DONGKHOA/MEASURE-POWER-AC/Firmware/ESP32/Measure_Power_AC/tbcmh/esp-mqtt_api.ods

Sheet: ESP-MQTT_API_&_Task_model
ESP-MQTT API | User context (User task) | MQTT event handler (Internal MQTT task) | Memo
esp_mqtt_client_init() | √
esp_mqtt_client_set_uri() | √ | *
esp_mqtt_client_start() | √
esp_mqtt_client_reconnect() | √
esp_mqtt_client_disconnect() | √
esp_mqtt_client_stop() | √ | X
esp_mqtt_client_subscribe() | √ | √ | Client must be connected to send subscribe message
esp_mqtt_client_unsubscribe() | √ | √ | Client must be connected to send unsubscribe message
esp_mqtt_client_publish() | √ | √ | This API might block for several seconds, either due to network timeout (10s) or if publishing payloads longer than internal buffer (due to message fragmentation)
esp_mqtt_client_enqueue() | √ | √ | This API generates and stores the publish message into the internal outbox and the actual sending to the network is performed in the mqtt-task context. Thus, it could be used as a non blocking version of esp_mqtt_client_publish().
esp_mqtt_client_destroy() | √ | X
esp_mqtt_set_config() | √ | *
esp_mqtt_client_register_event() | √
esp_mqtt_client_get_outbox_size() | √ | *
 |  |  | √:MUST, *:SHOULD, X:MUST NOT

Sheet: APIs_vs_function
Features API |  | MQTT | HTTP | CoAP
Telemetry upload API |  | PUBLISH, c->s | POST (REQ) | POST (REQ)
Attributes API | Publish attribute update to the server | PUBLISH, c->s | POST (REQ) | POST (REQ)
 | Request attribute values from the server | SUBSCRIBE, c->s PUBLISH(REQ), c->s PUBLISH(RES), c<-s | GET (REQ/request + RES/reply) | GET (REQ/request + RES/reply)
 | Subscribe to attribute updates from the server | SUBSCRIBE, c->s PUBLISH, c<-s | GET+timeout (RES/attr/timeout?) | GET+observe (RES/attr/?)
RPC API | Server-side RPC | SUBSCRIBE, c->s PUBLISH(REQ), c<-s PUBLISH(RES), c->s | GET+timeout (RES/request/timeout) POST (REQ/reply) | GET+observe (RES/attr/?) POST (REQ/reply)
 | Client-side RPC | SUBSCRIBE, c->s PUBLISH(REQ), c->s PUBLISH(RES), c<-s | POST (REQ/request + RES/reply) | POST (REQ/request + RES/reply)
Claiming devices |  | PUBLISH | POST (REQ) | POST (REQ)
Device provisioning |  | SUBSCRIBE, c->s PUBLISH(REQ), c->s PUBLISH(RES), c<-s | POST (REQ/request + RES/reply) | POST (REQ/request + RES/reply)
Firmware API | Request attribute values from the server(fw/sw) | SUBSCRIBE, c->s PUBLISH(REQ), c->s PUBLISH(RES), c<-s | GET (REQ/request + RES/reply) | GET (REQ/request + RES/reply)
 | Subscribe to attribute updates from the server (fw/sw) | SUBSCRIBE, c->s PUBLISH, c<-s | ??? | ???
 | New firmware update (fw/sw) | SUBSCRIBE, c->s PUBLISH(REQ), c->s PUBLISH(RES), c<-s | GET (REQ/request + RES/reply) | ???

Sheet: authentication_options
Device authentication options |  | MQTT (SSL/TLS) | HTTP (SSL/TLS) | CoAP (DTLS)
Access Token | without SSL | Plain MQTT | HTTP | CoAP
 | one-way SSL | MQTT over SSL | HTTPS | CoAP over DTLS
Basic MQTT authentication | without SSL | Plain MQTT | / | /
 | one-way SSL | MQTT over SSL | / | /
X.509 Certificate Based Authentication | two-way SSL | MQTT with X.509 | /? | CoAP with X.509 ?

Sheet: provision_options
Provision options | MQTT (SSL/TLS) | HTTP (SSL/TLS) | CoAP (DTLS)
Credentials generated by the ThingsBoard server | v | v | v
Devices supplies Access Token | v | v | v
Devices supplies Basic MQTT Credentials | v
Devices supplies X.509 Certificate | v |  | ?

Sheet: provision_params
Provisioning request | Parameter | Description | Credentials generated by the ThingsBoard server | Devices supplies Access Token | Devices supplies Basic MQTT Credentials | Devices supplies X.509 Certificate | esp_mqtt_client_config_t
 | deviceName | Device name in ThingsBoard. | (O) DEVICE_NAME | (O) DEVICE_NAME | (O) DEVICE_NAME | (O) DEVICE_NAME
 | provisionDeviceKey | Provisioning device key, you should take it from configured device profile. | (M) PUT_PROVISION_KEY_HERE | (M) PUT_PROVISION_KEY_HERE | (M) PUT_PROVISION_KEY_HERE | (M) PUT_PROVISION_KEY_HERE
 | provisionDeviceSecret | Provisioning device secret, you should take it from configured device profile. | (M) PUT_PROVISION_SECRET_HERE | (M) PUT_PROVISION_SECRET_HERE | (M) PUT_PROVISION_SECRET_HERE | (M) PUT_PROVISION_SECRET_HERE
 | credentialsType | Credentials type parameter. |  | (M) ACCESS_TOKEN | (M) MQTT_BASIC | (M) X509_CERTIFICATE
 | token | Access token for device in ThingsBoard. |  | (M) DEVICE_ACCESS_TOKEN
 | clientId | Client id for device in ThingsBoard. |  |  | (M) DEVICE_CLIENT_ID_HERE
 | username | Username for device in ThingsBoard. |  |  | (M) DEVICE_USERNAME_HERE
 | password | Password for device in ThingsBoard. |  |  | (M) DEVICE_PASSWORD_HERE
 | hash | Public key X509 hash for device in ThingsBoard. |  |  |  | (M) MIIB……..AQAB
 | (O) Optional, (M) Must
Provisioning response | deviceId |  |  |  |  | 3b829220-232f-11eb-9d5c-e9ed3235dff8
 | credentialsType |  | ACCESS_TOKEN | ACCESS_TOKEN | MQTT_BASIC | X509_CERTIFICATE
 | credentialsId |  |  |  |  | f307a1f717a12b32c27203cf77728d305d29f64694a8311be921070dd1259b3a
 | credentialsValue |  | sLzc0gDAZPkGMzFVTyUY | DEVICE_ACCESS_TOKEN |  | MIIB........AQAB | username
 | credentialsValue.clientId |  |  |  | DEVICE_CLIENT_ID_HERE |  | client_id | /*!< default client id is ``ESP32_%CHIPID%`` where %CHIPID% are last 3 bytes of MAC address in hex format */
 | credentialsValue.userName |  |  |  | DEVICE_USERNAME_HERE |  | username | /*!< MQTT username */
 | credentialsValue.password |  |  |  | DEVICE_PASSWORD_HERE |  | password | /*!< MQTT password */
 | provisionDeviceStatus |  |  |  |  | SUCCESS
 | status |  | SUCCESS | SUCCESS | SUCCESS
one-way SSL |  |  |  |  |  | ca_certs="mqttserver.pub.pem" | cert_pem | /*!< Pointer to certificate data in PEM or DER format for server verify (with SSL), default is NULL, not required to verify the server. PEM-format must have a terminating NULL-character. DER-format requires the length to be passed in cert_len. */
two-way SSL |  |  |  |  |  | certfile="cert.pem" | client_cert_pem | /*!< Pointer to certificate data in PEM or DER format for SSL mutual authentication, default is NULL, not required if mutual authentication is not needed. If it is not NULL, also `client_key_pem` has to be provided. PEM-format must have a terminating NULL-character. DER-format requires the length to be passed in client_cert_len. */
two-way SSL |  |  |  |  |  | keyfile="key.pem" | client_key_pem | /*!< Pointer to private key data in PEM or DER format for SSL mutual authentication, default is NULL, not required if mutual authentication is not needed. If it is not NULL, also `client_cert_pem` has to be provided. PEM-format must have a terminating NULL-character. DER-format requires the length to be passed in client_key_len */
 |  |  |  |  |  |  | const struct psk_key_hint *psk_hint_key; /*!< Pointer to PSK struct defined in esp_tls.h to enable PSK authentication (as alternative to certificate verification). If not NULL and server/client certificates are NULL, PSK is enabled */
 |  |  |  |  |  |  | bool use_global_ca_store; /*!< Use a global ca_store for all the connections in which this bool is set. */
 |  |  |  |  |  |  | esp_err_t (*crt_bundle_attach)(void *conf); /*!< Pointer to ESP x509 Certificate Bundle attach function for the usage of certification bundles in mqtts */
 |  |  |  |  |  |  | const char **alpn_protos; /*!< NULL-terminated list of supported application protocols to be used for ALPN */
 |  |  |  |  |  |  | const char *clientkey_password; /*!< Client key decryption password string */
 |  |  |  |  |  | tls_version=ssl.PROTOCOL_TLSv1_2 | esp_mqtt_protocol_ver_t protocol_ver; /*!< MQTT protocol version used for connection, defaults to value from menuconfig*/
 |  |  |  |  |  |  | bool skip_cert_common_name_check; /*!< Skip any validation of server certificate CN field, this reduces the security of TLS and makes the mqtt client susceptible to MITM attacks */
 |  |  |  |  |  |  | bool use_secure_element; /*!< enable secure element for enabling SSL connection */
 |  |  |  |  |  |  | void *ds_data; /*!< carrier of handle for digital signature parameters */

Sheet: python_cmd_params_of_auth
Device authentication options |  | token | clientId | username | password | ca_certs="mqttserver.pub.pem" | certfile="cert.pem" | keyfile="key.pem" | Default Port
Access Token | Plain MQTT (without SSL) | -u YOUR_ACCESS_TOKEN |  |  |  |  |  |  | -p "1883"
 | MQTTS (MQTT over SSL) | -u YOUR_ACCESS_TOKEN |  |  |  | --cafile tb-server-chain.pem |  |  | -p "8883"
Basic MQTT authentication | Authentication based on Client ID only |  | -i "YOUR_CLIENT_ID" |  |  |  |  |  | -p "1883"
 | Authentication based on Username and Password |  |  | -u "YOUR_CLIENT_USERNAME" | -P "YOUR_CLIENT_PASSWORD" |  |  |  | -p "1883"
 | Authentication based on Client ID, Username and Password |  | -i "YOUR_CLIENT_ID" | -u "YOUR_CLIENT_USERNAME" | -P "YOUR_CLIENT_PASSWORD" |  |  |  | -p "1883"
 | MQTTS (MQTT over TLS) |  | -i "YOUR_CLIENT_ID" | -u "YOUR_CLIENT_USERNAME" | -P "YOUR_CLIENT_PASSWORD" | --cafile tb-server-chain.pem |  |  | -p "8883"
X.509 Certificate Based Authentication | (two-way SSL) |  |  |  |  | --cafile tb-server-chain.pem | --cert cert.pem | --key key.pem | -p "8883"
 | -i: client ID
 | -u: user name
 | -P: password

Sheet: TBCMH_overview
SN | Function | on_create() | after_create() | on_connected() | working… | on_disconnected() | on_destroy() | Mode | Mode
1 | Telemetry | list_create() | item_register() item_unregister() |  | item_update() |  | item_empty() list_destroy() | only send
2 | Attributes request | list_create() |  | sub_resp() | send_req()? recv_resp(client_attr & shared attr) timeout_resp() | empty_req(timeout_resp()) | list_destroy() | req-resp | depend connection
3 | Client attribute | list_create() | item_register() item_unregister() |  | send_update() |  | item_empty() list_destroy() | only send or init+send
4 | Shared attribute | list_create() | item_register() item_unregister() | sub_update() | recv_update() |  | item_empty() list_destroy() | only recv
5 | Server RPC | list_create() | item_register() item_unregister() | sub_req() | recv_req() send_resp() |  | items_empty() list_destroy() | recv+send
6 | Client RPC | list_create() |  | sub_resp() | send_req() recv_resp() timeout_resp() | empty_req(timeout_resp()) | list_destroy() | req-resp | depend connection
7 | OTA update (Merge ota & chunk list to ONE) | list_create(ota) | item_register(ota) item_unregister(ota) |  | send_shared_attr_req(ota)? recv_shared_attr_resp(ota) timeout_shared_attr_resp(ota) |  | item_empty(ota) list_destroy(ota)
 |  | list_create(chunk) |  | sub_resp(chunk) | send_req(chunk) recv_resp(chunk) timeout_resp(chunk) | empty_req(timeout_resp(chunk)) | list_destroy(chunk) | req-resp | depend connection
8 | Device provision | list_create() |  | sub_resp() | send_req() recv_resp() timeout_resp() | empty_req(timeout_resp()) | list_destroy() | req-resp | depend connection
9 | Claiming device |  |  |  | send_claiming() |  |  | only send

Sheet: subscribe_&_unsubscribe
SN | Features | Subscribe | Unsubscribe
1 | timeseries_data | ————— | —————
2 | attributes_request | before sending request | after receiving respong or timeout
3 | attributes_update | ————— | —————
4 | attributes_subscribe | on connected | on disconnected
5 | client_rpc | before sending request | after receiving respong or timeout
6 | server_rpc | on connected | on disconnected
7 | claiming_device | ————— | —————
8 | ota_update | before sending request | after receiving respong or timeout
9 | device_provision | before sending request | after receiving respong or timeout
