DONGKHOA/MEASURE-POWER-AC/Ref/Lib_Hardware/BJT/MMBT2222A/MMBT2222A.step

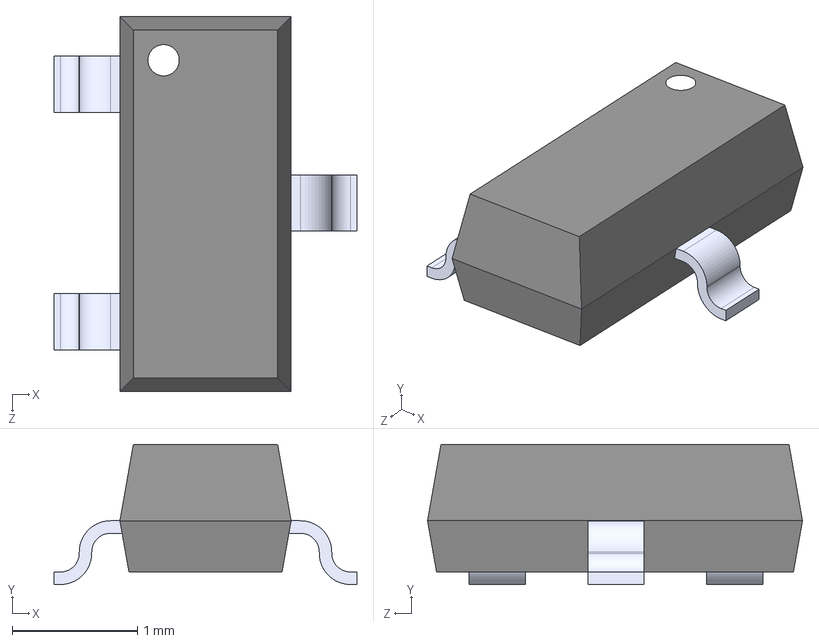
[picture p1: CAD file, 2024-11-23]
Ref/Lib_Hardware/BJT/MMBT2222A/MMBT2222A.step
2.42 x 1.12 x 3.00 mm
