DONGKHOA/MEASURE-POWER-AC/Ref/Lib_Hardware/Diode/BZT52C3V3-7-F/BZT52C3V3-7-F.step

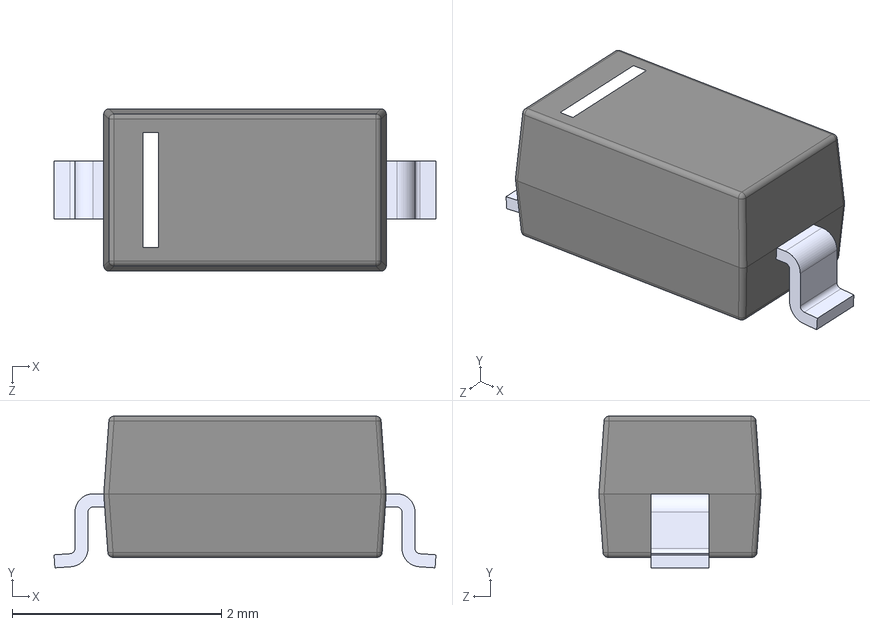
[picture p2: CAD file, 2024-11-23]
Ref/Lib_Hardware/Diode/BZT52C3V3-7-F/BZT52C3V3-7-F.step
3.65 x 1.45 x 1.55 mm
