DONGKHOA/MEASURE-POWER-AC/Ref/Lib_Hardware/Diode/SMF05C/SMF05C.step

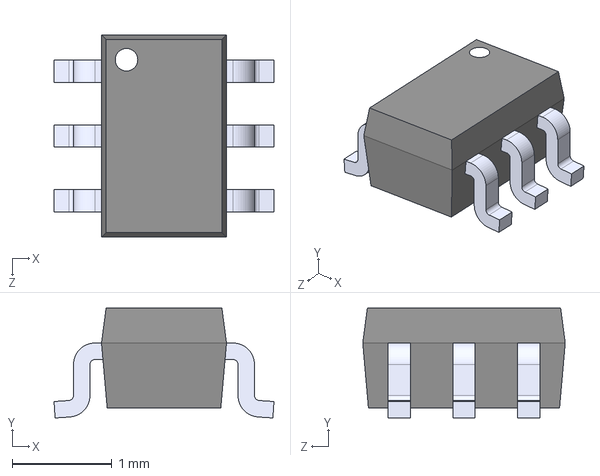
[picture p3: CAD file, 2024-11-23]
Ref/Lib_Hardware/Diode/SMF05C/SMF05C.step
2.20 x 1.10 x 2.03 mm
