DONGKHOA/MEASURE-POWER-AC/Ref/Lib_Hardware/Diode/SS34/SS34.step

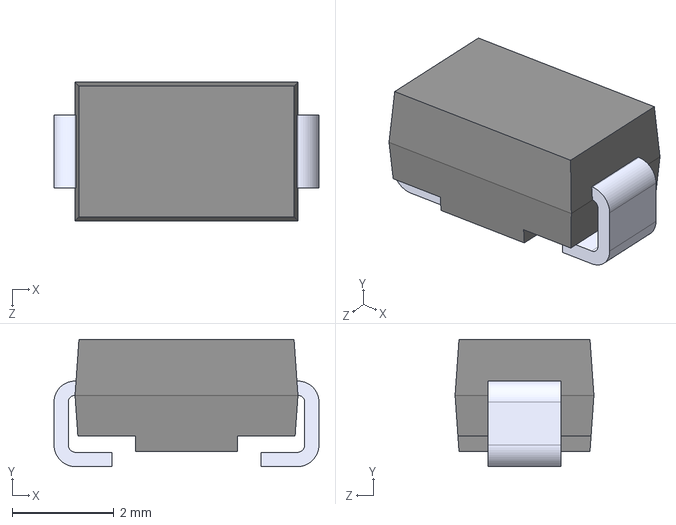
[picture p4: CAD file, 2024-11-23]
Ref/Lib_Hardware/Diode/SS34/SS34.step
5.20 x 2.50 x 2.72 mm
