DONGKHOA/MEASURE-POWER-AC/Ref/Lib_Hardware/Jack/DC-005-5A-2.0/DC-005-5A-2.0.step

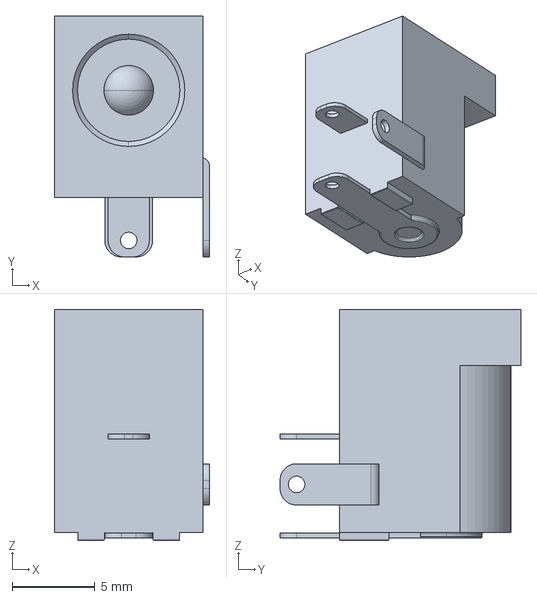
[picture p5: CAD file, 2024-11-23]
Ref/Lib_Hardware/Jack/DC-005-5A-2.0/DC-005-5A-2.0.step
9.40 x 14.6 x 14.0 mm
