DONGKHOA/MEASURE-POWER-AC/Ref/Lib_Hardware/MCU/ESP32-WROOM-32E__4MB_HIGH_TEMP_/ESP32-WROOM-32E__4MB_HIGH_TEMP_.step

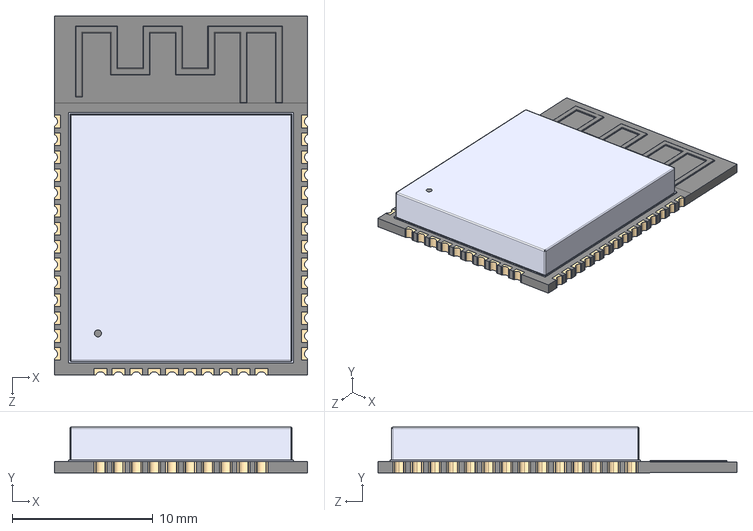
[picture p6: CAD file, 2024-11-23]
Ref/Lib_Hardware/MCU/ESP32-WROOM-32E__4MB_HIGH_TEMP_/ESP32-WROOM-32E__4MB_HIGH_TEMP_.step
18.0 x 3.25 x 25.5 mm
