DONGKHOA/MEASURE-POWER-AC/Ref/Lib_Hardware/Op_Amp/INA128UA/INA128UA.step

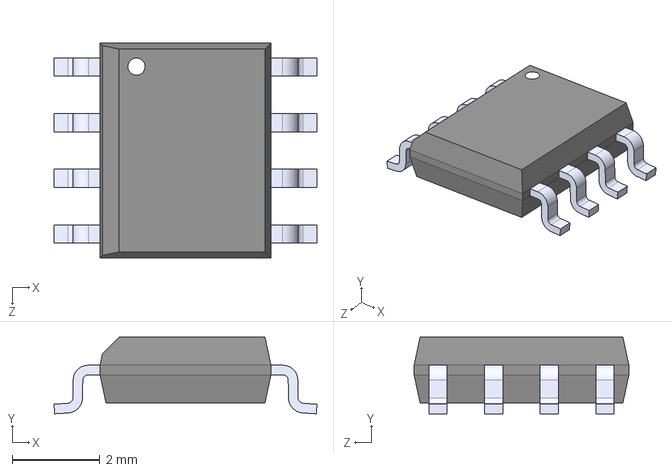
[picture p7: CAD file, 2024-11-23]
Ref/Lib_Hardware/Op_Amp/INA128UA/INA128UA.step
6.00 x 1.75 x 4.90 mm
