DONGKHOA/MEASURE-POWER-AC/Ref/Lib_Hardware/Op_Amp/MCP6002-E_SN/MCP6002-E_SN.step

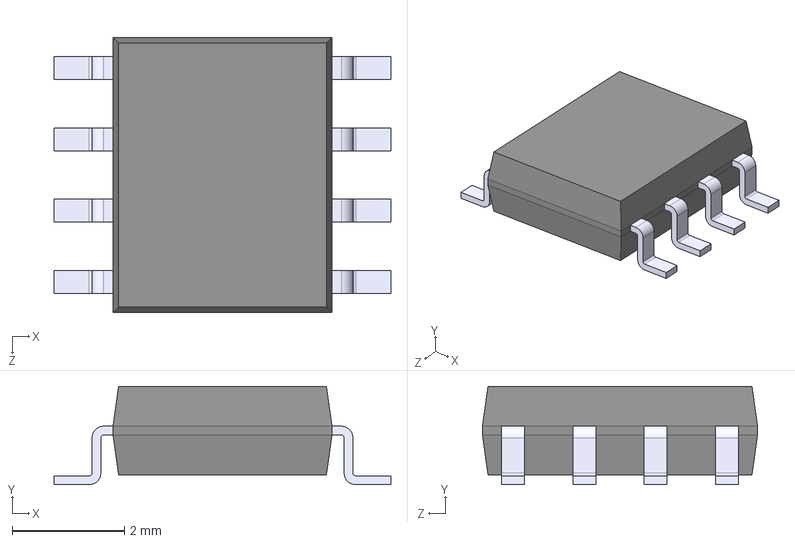
[picture p8: CAD file, 2024-11-23]
Ref/Lib_Hardware/Op_Amp/MCP6002-E_SN/MCP6002-E_SN.step
6.00 x 1.75 x 4.90 mm
