DONGKHOA/MEASURE-POWER-AC/Ref/Lib_Hardware/Opto/PC817X2NIP0F/PC817X2NIP0F.step

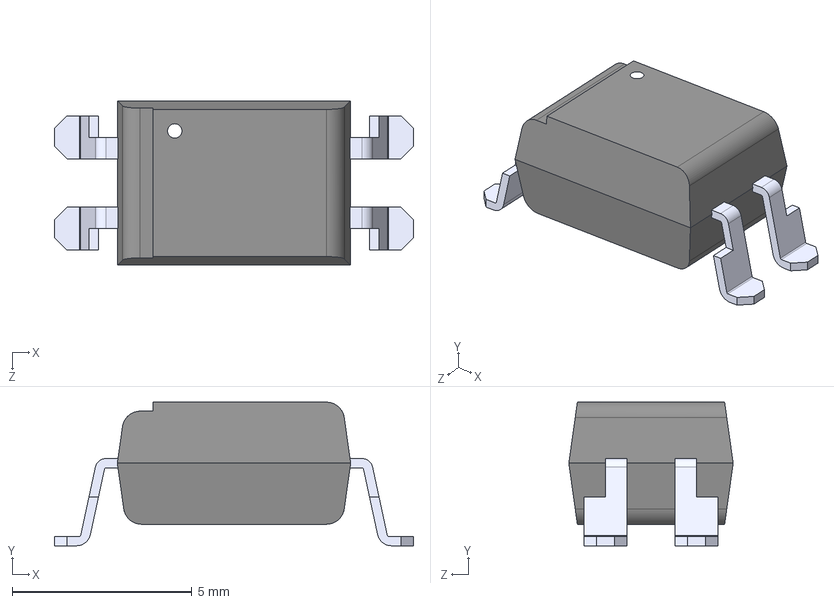
[picture p9: CAD file, 2024-11-23]
Ref/Lib_Hardware/Opto/PC817X2NIP0F/PC817X2NIP0F.step
10.0 x 4.00 x 4.58 mm
