DONGKHOA/MEASURE-POWER-AC/Ref/Lib_Hardware/Relay/SRA-05VDC-CL/SRA-05VDC-CL.step

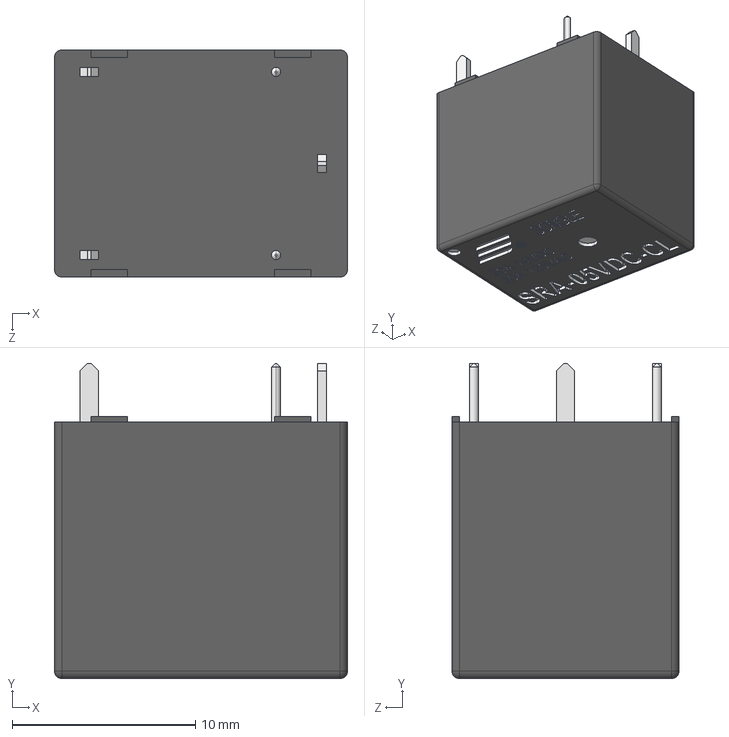
[picture p10: CAD file, 2024-11-23]
Ref/Lib_Hardware/Relay/SRA-05VDC-CL/SRA-05VDC-CL.step
16.0 x 17.2 x 12.4 mm
