DONGKHOA/MEASURE-POWER-AC/Ref/Lib_Hardware/Relay/SRD-05VDC-SL-C/SRD-05VDC-SL-C.step

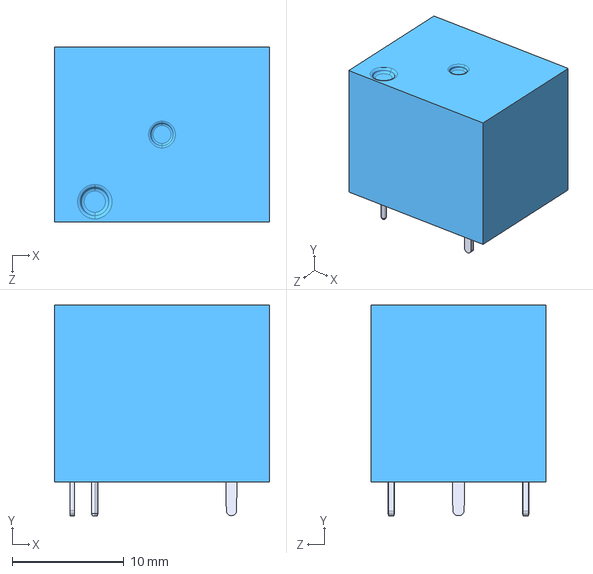
[picture p11: CAD file, 2024-11-23]
Ref/Lib_Hardware/Relay/SRD-05VDC-SL-C/SRD-05VDC-SL-C.step
19.2 x 18.8 x 15.6 mm
