DONGKHOA/MEASURE-POWER-AC/Ref/Lib_Hardware/Tantalum/TAJA105K016RNJ/TAJA105K016RNJ.step

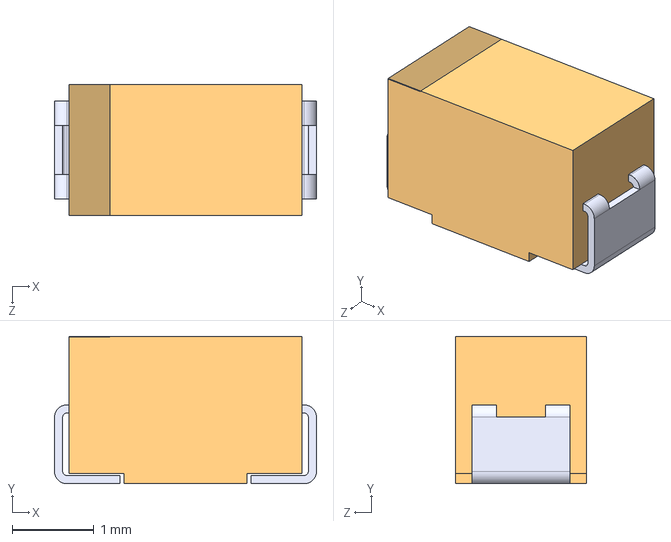
[picture p12: CAD file, 2024-11-23]
Ref/Lib_Hardware/Tantalum/TAJA105K016RNJ/TAJA105K016RNJ.step
3.20 x 1.80 x 1.60 mm
