DONGKHOA/MEASURE-POWER-AC/Ref/Lib_Hardware/UART/R_0805_2012Metric.step

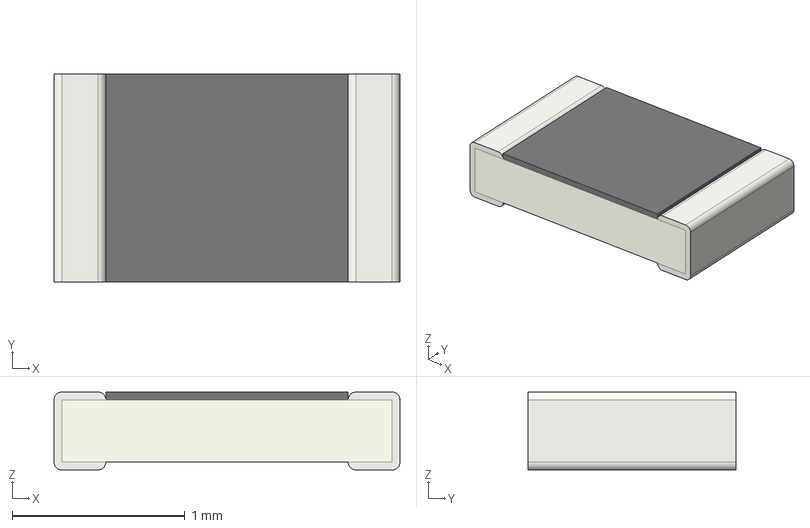
[picture p13: CAD file, 2024-11-23]
Ref/Lib_Hardware/UART/R_0805_2012Metric.step
2.00 x 1.20 x 0.45 mm
