DONGKHOA/MEASURE-POWER-AC/Ref/Lib_Hardware/Varistor/MOV-14D471K/MOV-14D471K.step

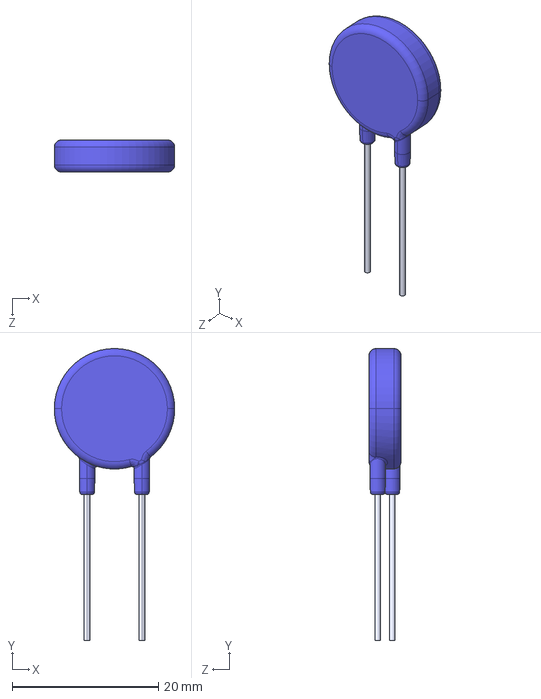
[picture p14: CAD file, 2024-11-23]
Ref/Lib_Hardware/Varistor/MOV-14D471K/MOV-14D471K.step
16.5 x 40.0 x 4.40 mm
