DONGKHOA/MEASURE-POWER-AC/Ref/Lib_Hardware/UART/R_1206_3216Metric.step

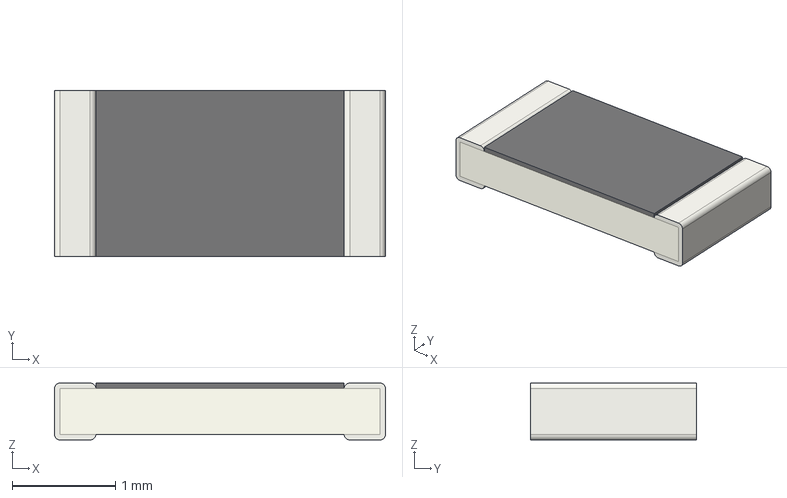
[picture p15: CAD file, 2024-11-23]
Ref/Lib_Hardware/UART/R_1206_3216Metric.step
3.20 x 1.60 x 0.55 mm
