DONGKHOA/MEASURE-POWER-AC/Ref/Lib_Hardware/Varistor/MOV-14D471K/MOV-07D471K.STEP

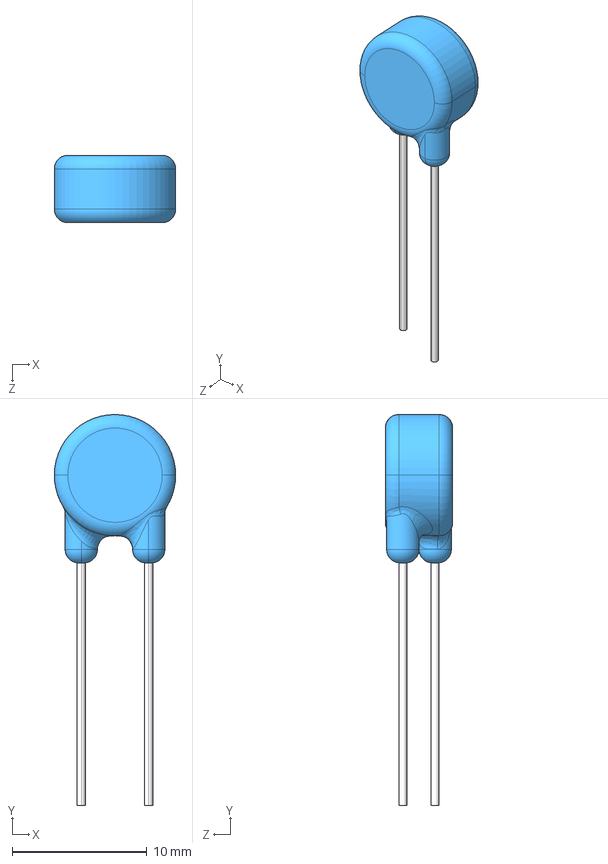
[picture p16: CAD file, 2024-11-23]
Ref/Lib_Hardware/Varistor/MOV-14D471K/MOV-07D471K.STEP
9.00 x 29.0 x 5.00 mm
