DONGKHOA/MEASURE-POWER-AC/Simulation/Test_BOD/Bode Gain - Phase -HPF.jpg

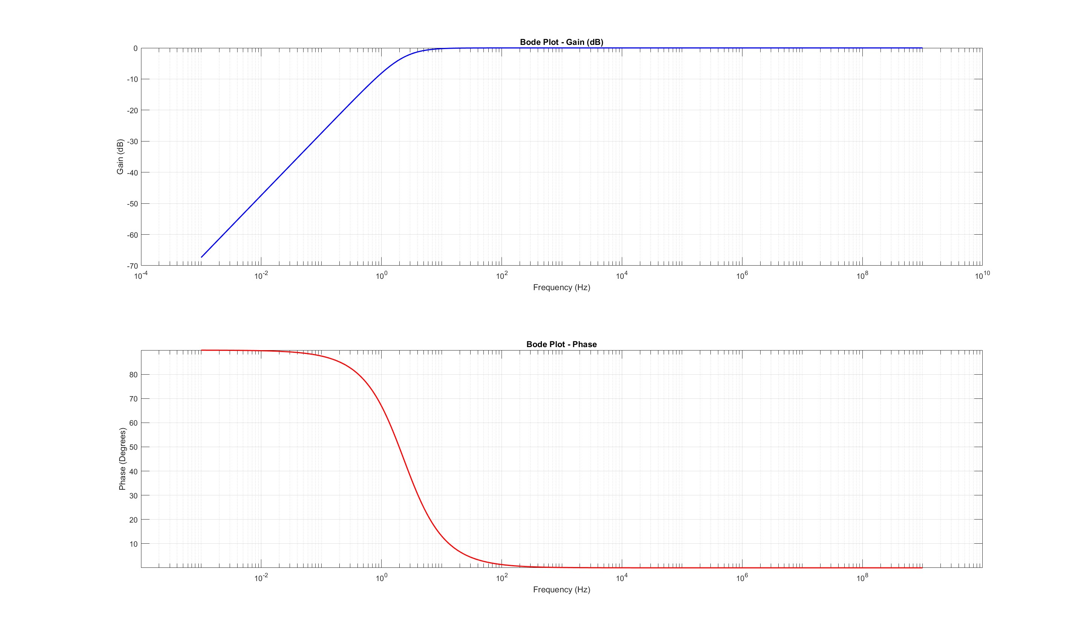
Simulation/Test_BOD/Bode Gain - Phase -HPF.jpg
