DONGKHOA/MEASURE-POWER-AC/Simulation/Test_BOD/Bode Gain - Phase.jpg

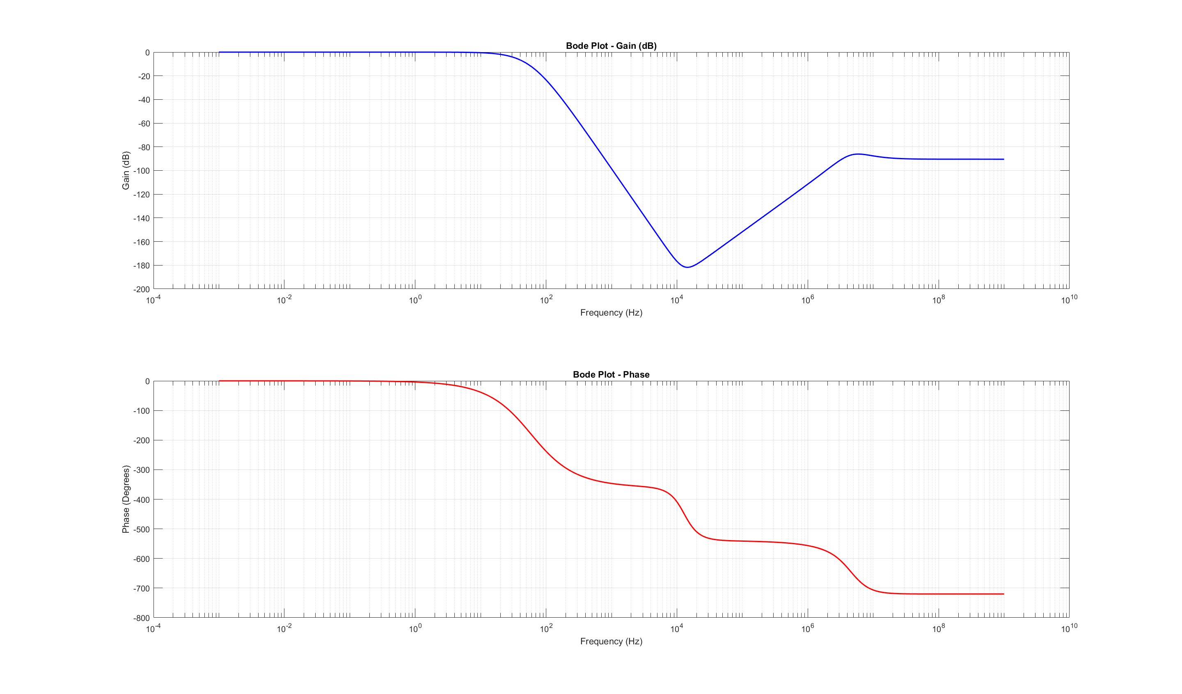
Simulation/Test_BOD/Bode Gain - Phase.jpg
