DONGKHOA/MEASURE-POWER-AC/Simulation/Test_BOD/Bode Gain.jpg

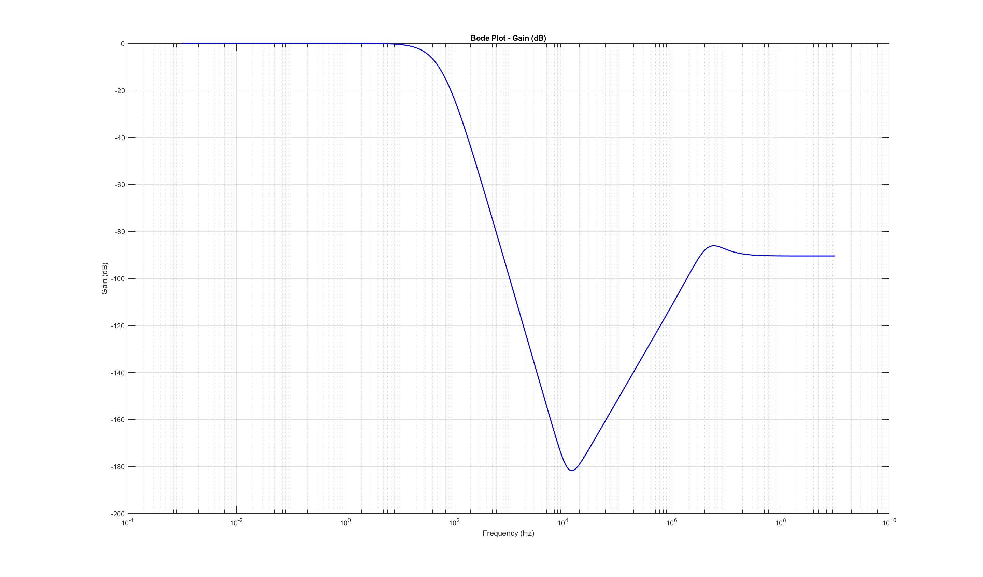
Simulation/Test_BOD/Bode Gain.jpg
