DONGKHOA/MEASURE-POWER-AC/Simulation/Test_BOD/Bode Phase.jpg

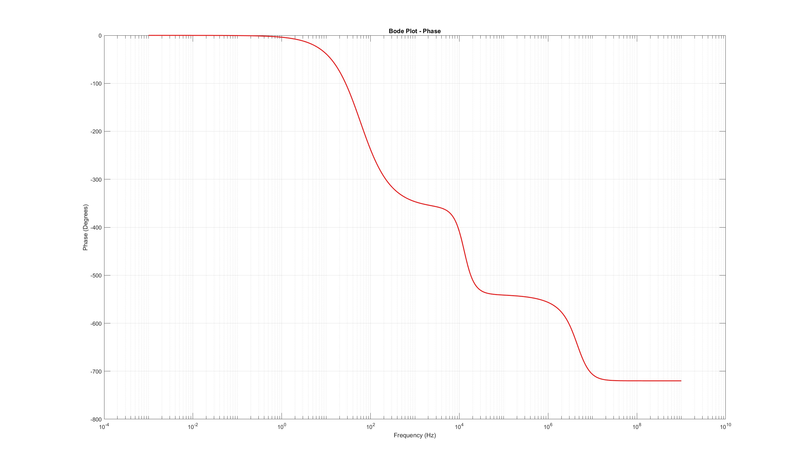
Simulation/Test_BOD/Bode Phase.jpg
