DONGKHOA/MEASURE-POWER-AC/Ref/2024-03-21_20-39_ESP_Smart-Outlet_Schematics.PDF

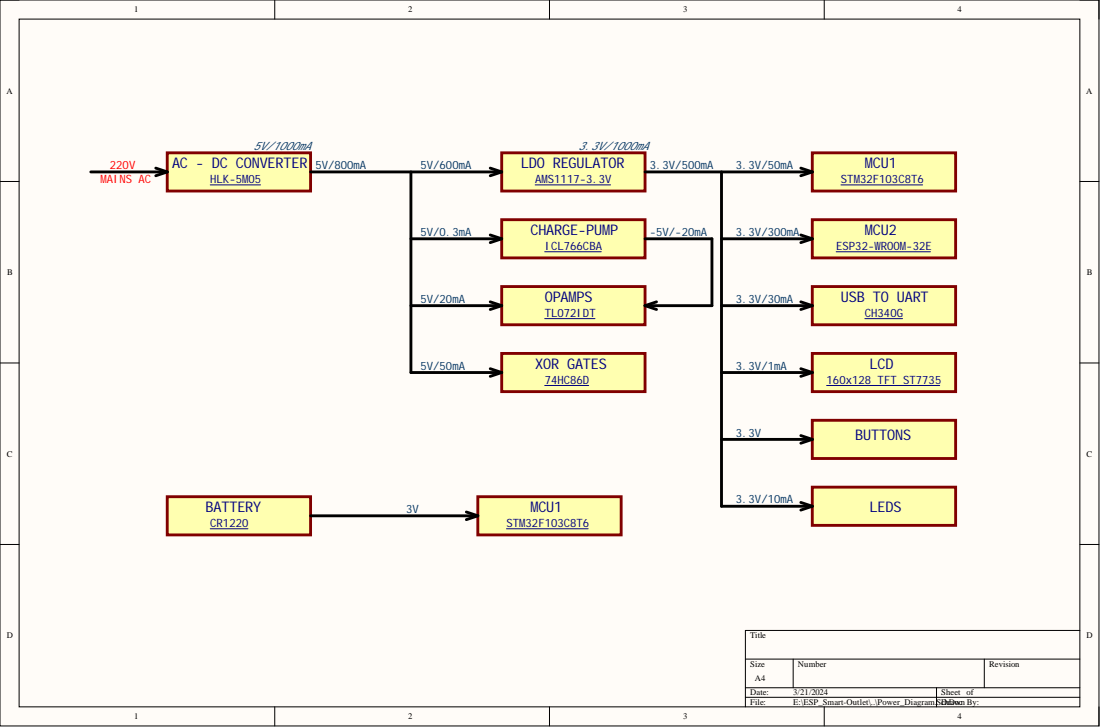
[picture p21: page 1]

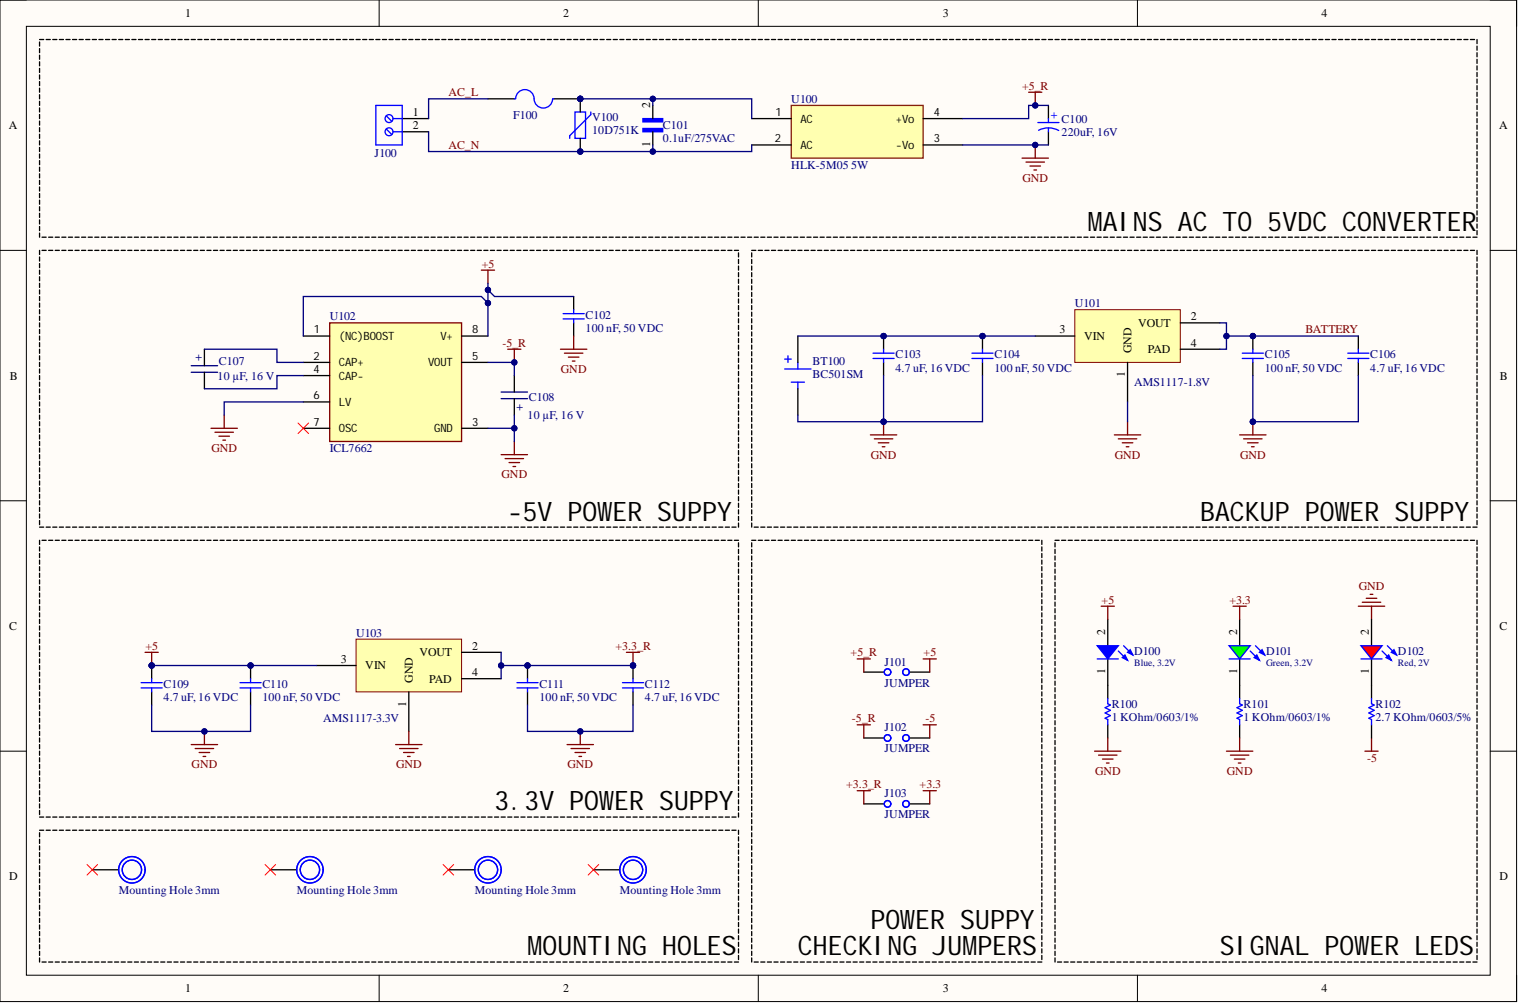
[picture p22: page 2]

GND
MAINS AC TO 5VDC CONVERTER

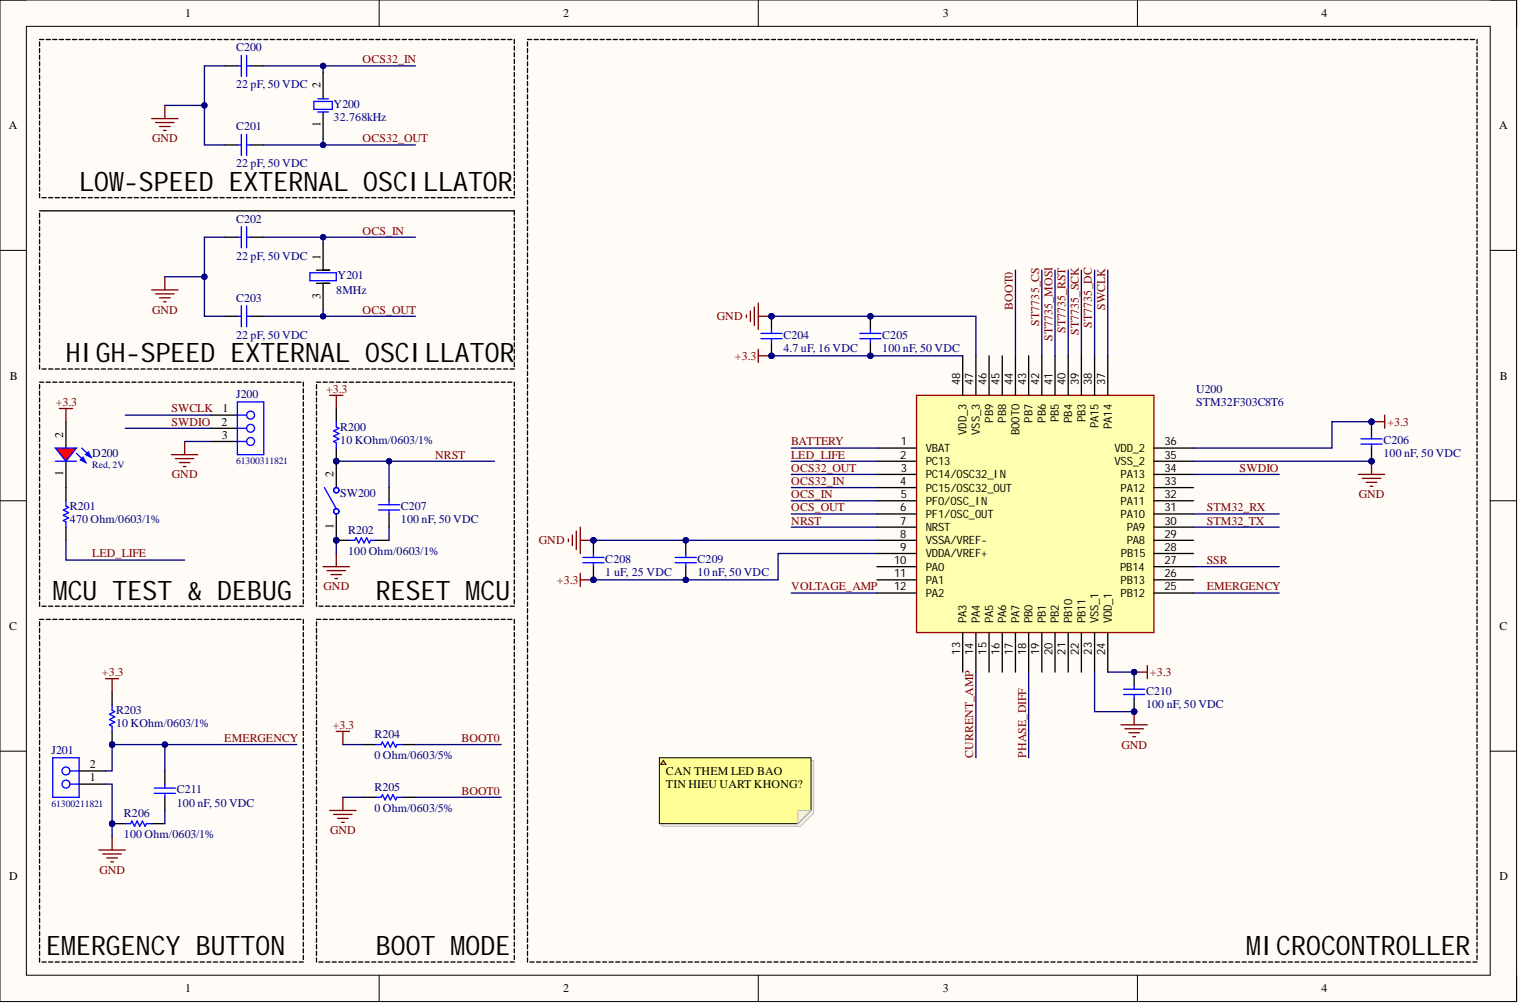
[picture p23: page 3]

LOW-SPEED EXTERNAL OSCILLATOR

HIGH-SPEED EXTERNAL OSCILLATOR

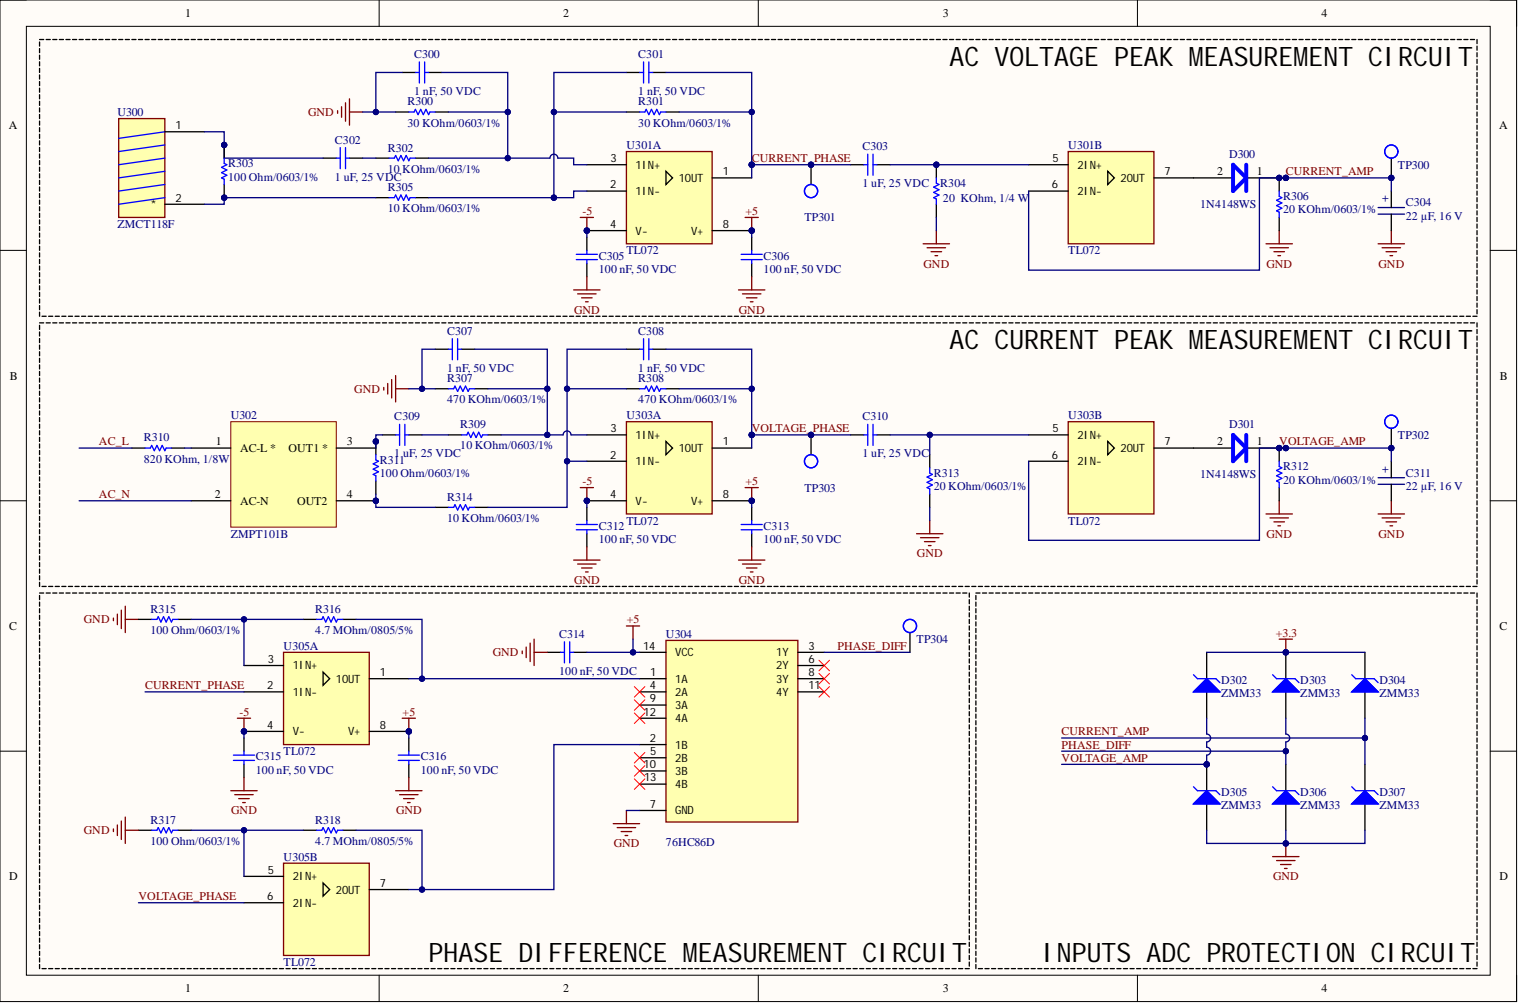
[picture p24: page 4]

AC VOLTAGE PEAK MEASUREMENT CIRCUIT

AC CURRENT PEAK MEASUREMENT CIRCUIT

PHASE_DIFF
VOLTAGE_AMP

C316 100 nF, 50 VDC | 2B 5

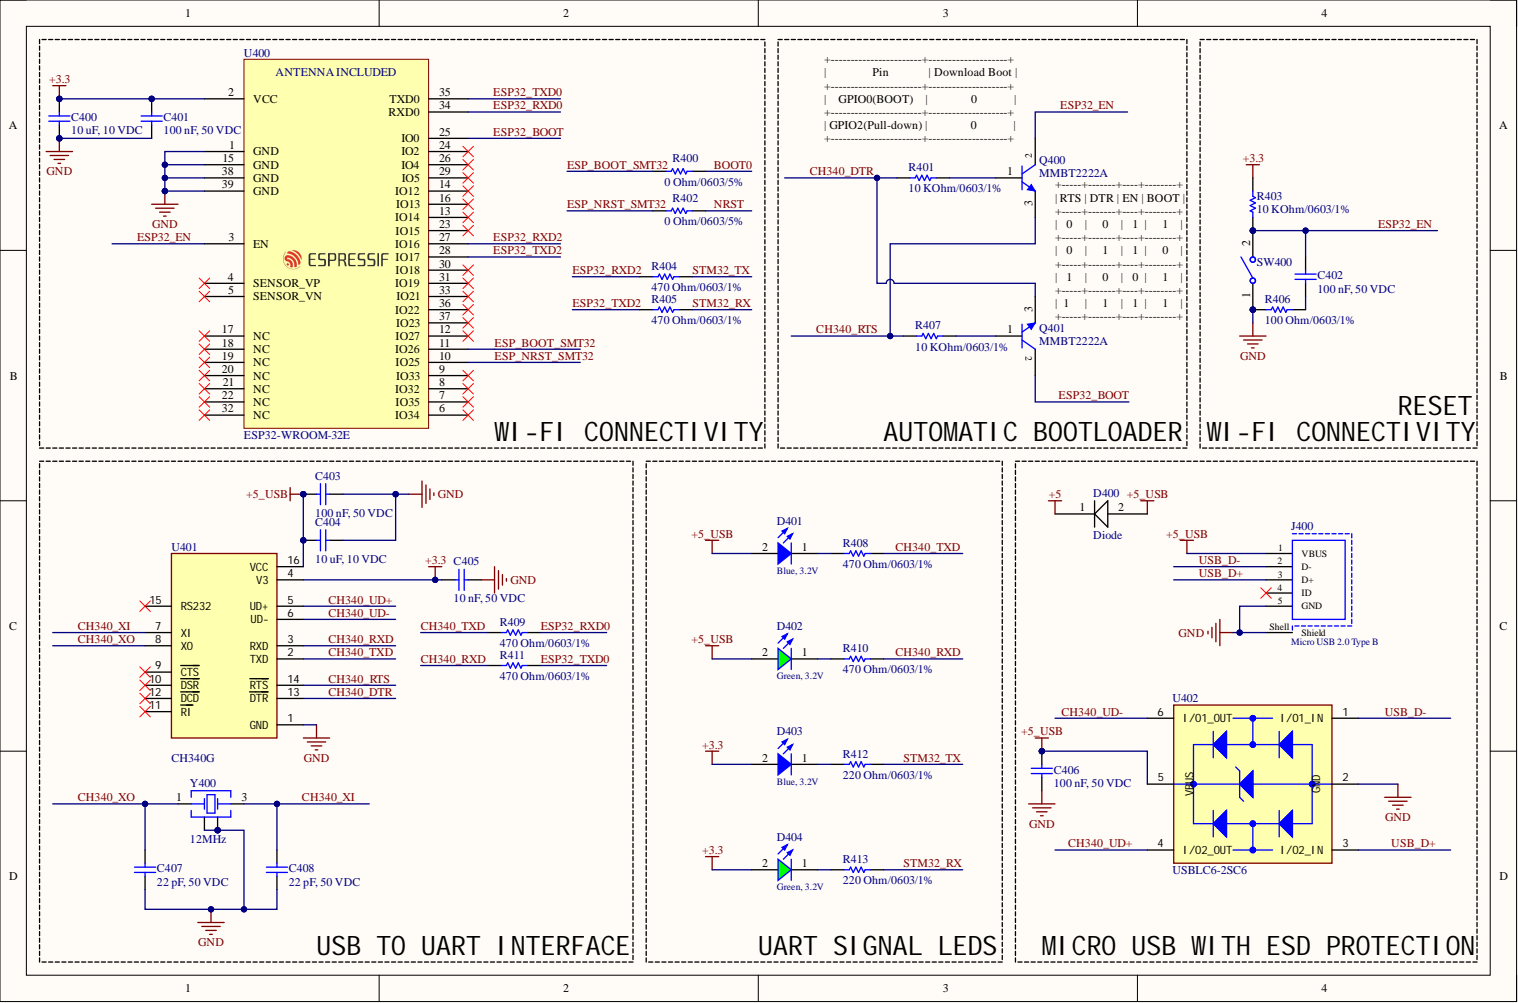
[picture p25: page 5]

GND 1

GND 38

I/O1_OUT 6

I/O2_OUT 4

USB TO UART INTERFACE

MICRO USB WITH ESD PROTECTION

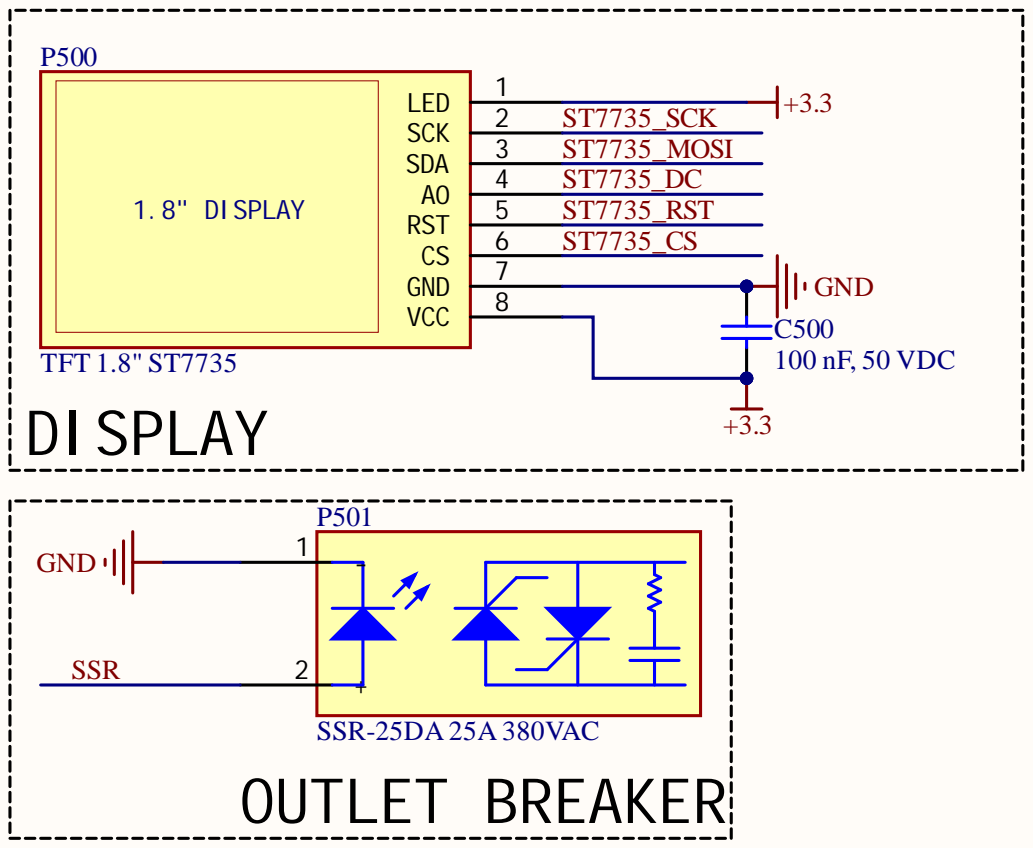
[picture p26: page 6]
