DONGKHOA/MEASURE-POWER-AC/(list of files, drawings)

Other design files:
Simulation/Change_Range_ACS/Change_Range_ACS.ms14
Simulation/Current-Measurement/Current_Measurement.ms14
Simulation/Design1.ms14
Simulation/High-Pass_Filt.ms14
Simulation/Low-Pass _Filt_4.ms14
Simulation/Peak-Detector/Peak_Detector.ms14
Simulation/Voltage-Measurement/Dectect_voltage.ms14
Simulation/Voltage-Measurement/Voltage_measurement.ms14
