DONGKHOA/MEASURE-POWER-AC/Firmware/STM32/Core/Src/main.c

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
/* Includes ------------------------------------------------------------------*/
#include "main.h"

/* USER CODE BEGIN Includes */

#include "adc.h"
#include "app_data.h"
#include "scheduler.h"
#include "app_command.h"
#include "app_led_7seg.h"
#include "app_read_data.h"
#include "app_status_led.h"
#include "app_calculator_PF.h"
#include "app_data_trans_rec.h"

/* USER CODE END Includes */


UART_HandleTypeDef huart1;

void SystemClock_Config(void);
static void MX_GPIO_Init(void);
static void MX_DMA_Init(void);
static void MX_ADC1_Init(void);
static void MX_USART1_UART_Init(void);
static void MX_USART3_UART_Init(void);
static void MX_TIM2_Init(void);
static void MX_TIM3_Init(void);
/**
  * @brief  The application entry point.
  * @retval int
  */
int main(void)
{

  /* MCU Configuration--------------------------------------------------------*/

  /* Reset of all peripherals, Initializes the Flash interface and the Systick. */
  HAL_Init();

  /* Configure the system clock */
  SystemClock_Config();

  /* Initialize all configured peripherals */
  MX_GPIO_Init();
  MX_DMA_Init();
  MX_ADC1_Init();
  MX_USART1_UART_Init();
  MX_USART3_UART_Init();
  MX_TIM2_Init();
  MX_TIM3_Init();
  /* USER CODE BEGIN 2 */


  // Application Initialize
  APP_READ_DATA_Init();
  APP_CALCULATOR_PF_Init();
  APP_DATA_TRANS_REC_Init();
  APP_COMMAND_Init();
  APP_STATUS_LED_Init();
  APP_LED_7_SEG_Init();

  // Initialize Scheduler
  SCH_Initialize();

  // Create Timer
  APP_STATUS_LED_CreateTimer();

  // Application Create Task
  APP_READ_DATA_CreateTask();
  APP_CALCULATOR_PF_CreateTask();
  APP_DATA_TRANS_REC_CreateTask();
  APP_COMMAND_CreateTask();
  APP_STATUS_LED_CreateTask();
//  APP_LED_7_SEG_CreateTask();

  // Start Scheduler
  SCH_StartScheduler();

  // Start ADC - TIM3
  BSP_ADC_Start_Calibration(ADC1);
  BSP_ADC_Start_DMA(ADC1, (uint16_t *)s_data_system.u16_adc_value, 2);
  TIM3->CR1 |= TIM_CR1_CEN;

  /* USER CODE END 2 */

  /* Infinite loop */
  /* USER CODE BEGIN WHILE */
  while (1)
  {
    /* USER CODE END WHILE */

    /* USER CODE BEGIN 3 */
	  SCH_HandleScheduledTask();
  }
  /* USER CODE END 3 */
}

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
