DONGKHOA/MEASURE-POWER-AC/Ref/BTL_ESP/main/main.h

#ifndef MAIN_H
#define MAIN_H

/******************************************************************************
 *      INCLUDES
 *****************************************************************************/

#include <stdio.h>
#include <stdint.h>
#include <string.h>

#include "freertos/FreeRTOS.h"
#include "freertos/task.h"
#include "freertos/timers.h"
#include "freertos/queue.h"
#include "freertos/event_groups.h"
#include "freertos/semphr.h"

#include "esp_system.h"
#include "esp_event.h"
#include "esp_log.h"
#include "esp_err.h"
#include "esp_wifi.h"
#include "rom/ets_sys.h"

#include "wifi.h"
#include "gpio.h"
#include "nvs_rw.h" 
#include "uart_driver.h"
#include "mqtt_client_tcp.h"
#include "http_client_request.h"

/*********************
 *      DEFINES
 *********************/

#define MAIN_TAG    "Main"

// IO UART
#define TXD_PIN                                 (GPIO_NUM_17)
#define RXD_PIN                                 (GPIO_NUM_15)

#define MIN_STACK_SIZE                          1024

#define TIME_MQTT_SUBSCRIBE                     2000
#define TIME_REQUEST_SCAN                       3000

#define SSID_IN_PAGE                            5

// UART RX EVENT 
#define ON_WIFI_BIT                             (1 << 0)
#define OFF_WIFI_BIT                            (1 << 1)
#define NEXT_PAGE_BIT						    (1 << 2)
#define BACK_PAGE_BIT						    (1 << 3)
#define CONNECT_WIFI_RX_BIT                     (1 << 4)
#define CONNECT_WIFI_SCAN_BIT                   (1 << 5)
#define CONNECT_MQTT_BIT                        (1 << 6)

// UART TX EVENT 
#define SCAN_WIFI_BIT	                        (1 << 0)
#define SEND_CONNECT_WIFI_SUCCESSFUL_BIT        (1 << 1)
#define SEND_CONNECT_WIFI_UNSUCCESSFUL_BIT      (1 << 2)
#define SEND_REFUSE_CONNECT_MQTT_BIT            (1 << 3)
#define SEND_CONNECT_MQTT_SUCCESSFUL_BIT        (1 << 4)
#define SEND_MQTT_SUBSCRIBE                     (1 << 6)
#define SEND_CONNECT_MQTT_UNSUCCESSFUL_BIT      (1 << 5)

/**********************
 *      TYPEDEFS
 **********************/

typedef enum 
{
    HEADING_WIFI = 0x01,
    HEADING_TAB_PAGE,       // 2
    HEADING_CONNECT_WIFI,   // 3
    HEADING_CONNECT_MQTT,   // 4
    HEADING_MQTT_PUBLISH,   // 5
} uart_rx_heading_t;

typedef enum
{
    HEADING_SEND_SCAN_WIFI = 0x01,
    HEADING_SEND_CONNECT_WIFI,
    HEADING_SEND_CONNECT_MQTT,
    HEADING_MQTT_SUBSCRIBE,
} uart_tx_heading_t;

typedef enum
{
    MQTT_PUBLISH,
    MQTT_SUBSCRIBE,
} mqtt_command_t;

/*********************
 *   INLINE FUNCTION
 *********************/

static inline void getSSID_PASS(uint8_t * data, uint8_t *ssid, uint8_t * pass)
{
	char buffer[64];
    memcpy(buffer, data, strlen((char *) data));
    uint8_t arg_position = 0;
    
	// cut string
	char *temp_token = strtok(buffer, "\r");
	while (temp_token != NULL)
	{
        if (arg_position == 0)
        {
            memcpy(ssid, temp_token, strlen((char *)temp_token) + 1);
        }
        else if (arg_position == 1)
        {
            memcpy(pass, temp_token, strlen((char *)temp_token) + 1);
            break;
        }
        arg_position++;
		temp_token = strtok(NULL, "\r");
	}
}

static inline int8_t matchingWIFIScan(char * data, uint8_t * ssid, uint8_t *pass)
{
	char *arg_list[50];
    char buffer[1024];
    memcpy(buffer, data, strlen((char *) data));
    uint8_t arg_position = 0;

    // cut string
    char *temp_token = strtok(buffer, "\r");
    while(temp_token != NULL)
    {
        arg_list[arg_position]= temp_token;
        arg_position++;
        temp_token = strtok(NULL, "\r");
    }

    // check matching ssid in NVS
    for (uint8_t i = 0; i < arg_position; i++)
    {
        if (WIFI_ScanNVS((uint8_t *)arg_list[i], pass) != -1)
        {
            memcpy(ssid, arg_list[i], strlen((char *)arg_list[i]) + 1);
            return 1;
        }
    }
    return -1;
}

static inline void processingDataMQTTPublish(char * data, char *state_led, 
                char * state_auto, char *lux, char * temperature)
{
    char buffer[1024];
    memcpy(buffer, data, strlen((char *) data));
    uint8_t arg_position = 0;

    // cut string
    
    char *temp_token = strtok(buffer, "\r");
    while(temp_token != NULL)
    {
        if (arg_position == 0)
        {
            memcpy(state_led, temp_token, strlen((char *)temp_token) + 1);
        }
        else if (arg_position == 1)
        {
            memcpy(state_auto, temp_token, strlen((char *)temp_token) + 1);
        }
        else if (arg_position == 2)
        {
            memcpy(lux, temp_token, strlen((char *)temp_token) + 1);
        }
        else if (arg_position == 3)
        {
            memcpy(temperature, temp_token, strlen((char *)temp_token) + 1);
        }
        arg_position++;
        
        temp_token = strtok(NULL, "\r");
    }
}

/*********************
 *   GLOBAL FUNCTION
 *********************/

void transmissionFrameData(uart_tx_heading_t heading, char *data)
{
    uartSendData(UART_NUM_1, (char *)&heading);
    uartSendData(UART_NUM_1, data);
    uartSendData(UART_NUM_1, "\n");
    
}
#endif /* MAIN_H */
