DONGKHOA/MEASURE-POWER-AC/Firmware/ESP32/Measure_Power_AC/APP/app_button/app_button.h

#ifndef APP_BUTTON_H_
#define APP_BUTTON_H_

/******************************************************************************
 *      INCLUDES
 *****************************************************************************/

#include <stdio.h>

#ifdef __cplusplus
extern "C"
{
#endif

  /****************************************************************************
   *   PUBLIC FUNCTION
   ***************************************************************************/

  void APP_Button_CreateTask(void);
  void APP_Button_Init(void);

#ifdef __cplusplus
}
#endif

#endif /* APP_BUTTON_H_ */
