DONGKHOA/MEASURE-POWER-AC/Firmware/ESP32/Measure_Power_AC/APP/app_status_led/app_status_led.h

#ifndef APP_STATUS_LED_H_
#define APP_STATUS_LED_H_

/******************************************************************************
 *      INCLUDES
 *****************************************************************************/

#include <stdio.h>

#ifdef __cplusplus
extern "C"
{
#endif

  /****************************************************************************
   *   PUBLIC FUNCTION
   ***************************************************************************/

  void APP_Status_led_CreateTask(void);
  void APP_Status_led_Init(void);

#ifdef __cplusplus
}
#endif

#endif /* APP_STATUS_LED_H_ */
