DONGKHOA/MEASURE-POWER-AC/Firmware/ESP32/Measure_Power_AC/APP/app_data_Rec/app_data_rec.h

#ifndef APP_DATA_REC_H_
#define APP_DATA_REC_H_

/******************************************************************************
 *      INCLUDES
 *****************************************************************************/

#include <stdio.h>

#ifdef __cplusplus
extern "C"
{
#endif

  /****************************************************************************
   *   PUBLIC FUNCTION
   ***************************************************************************/

  void APP_Data_rec_CreateTask(void);
  void APP_Data_rec_Init(void);

#ifdef __cplusplus
}
#endif

#endif /* APP_DATA_REC_H_ */
