DONGKHOA/MEASURE-POWER-AC/(commit log)

2024-11-14 upload project
    [BZT52C3V3-7-F.step, DC-005-5A-2.0.step, ESP32-WROOM-32E__4MB_HIGH_TEMP_.step, INA128UA.step, MCP6002-E_SN.step, MEASURE_POWER_AC.kicad_pcb, MEASURE_POWER_AC.kicad_sch, MMBT2222A.step]
2024-11-16 Update Schematic: Test_Board
    [Connectors.kicad_sch, Current_Measurement.kicad_sch, Current_Measurement.ms14, Dectect_voltage.ms14, MCU.kicad_sch, Peak_Detector.kicad_sch, Peak_Detector.ms14, Power_Supply.kicad_sch]
2024-11-19 update FIRMWARE STM32
2024-11-23 Update PCB
    [Change_Range_ACS.ms14, Connectors.kicad_sch, Current_Measurement.kicad_sch, Display.kicad_sch, ESP32.kicad_sch, MCU.kicad_sch, MEASURE_POWER_AC.kicad_sch, Peak_Detector.kicad_sch]
2024-11-30 update esp32
2024-12-01 Update BOM
    [BOMLIST.xlsx, Connectors.kicad_sch, Current_Measurement.kicad_sch, ESP32.kicad_sch, MCU.kicad_sch, MEASURE_POWER_AC.csv, Peak_Detector.kicad_sch, Voltage_Measurement.kicad_sch]
2024-12-01 Modified STM32 LED 7 Segments pin
2025-01-07 Update ESP32 Firmware: Error at clear all data thingsboard
    [app_button.c, app_data_rec.c, app_status_led.c]
2025-01-09 Update Codes of ESP32 and STM32
2025-04-20 update version kicad
    [Connectors.kicad_sch, Current_Measurement.kicad_sch, Display.kicad_sch, ESP32.kicad_sch, MCU.kicad_sch, MEASURE_POWER_AC.kicad_sch, Peak_Detector.kicad_sch, Power_Supply.kicad_sch]
